golioth/elixir-hw/elixir-mechanical.kicad_sch

## KiCad design elixir-mechanical.kicad_sch (2024-07-08)

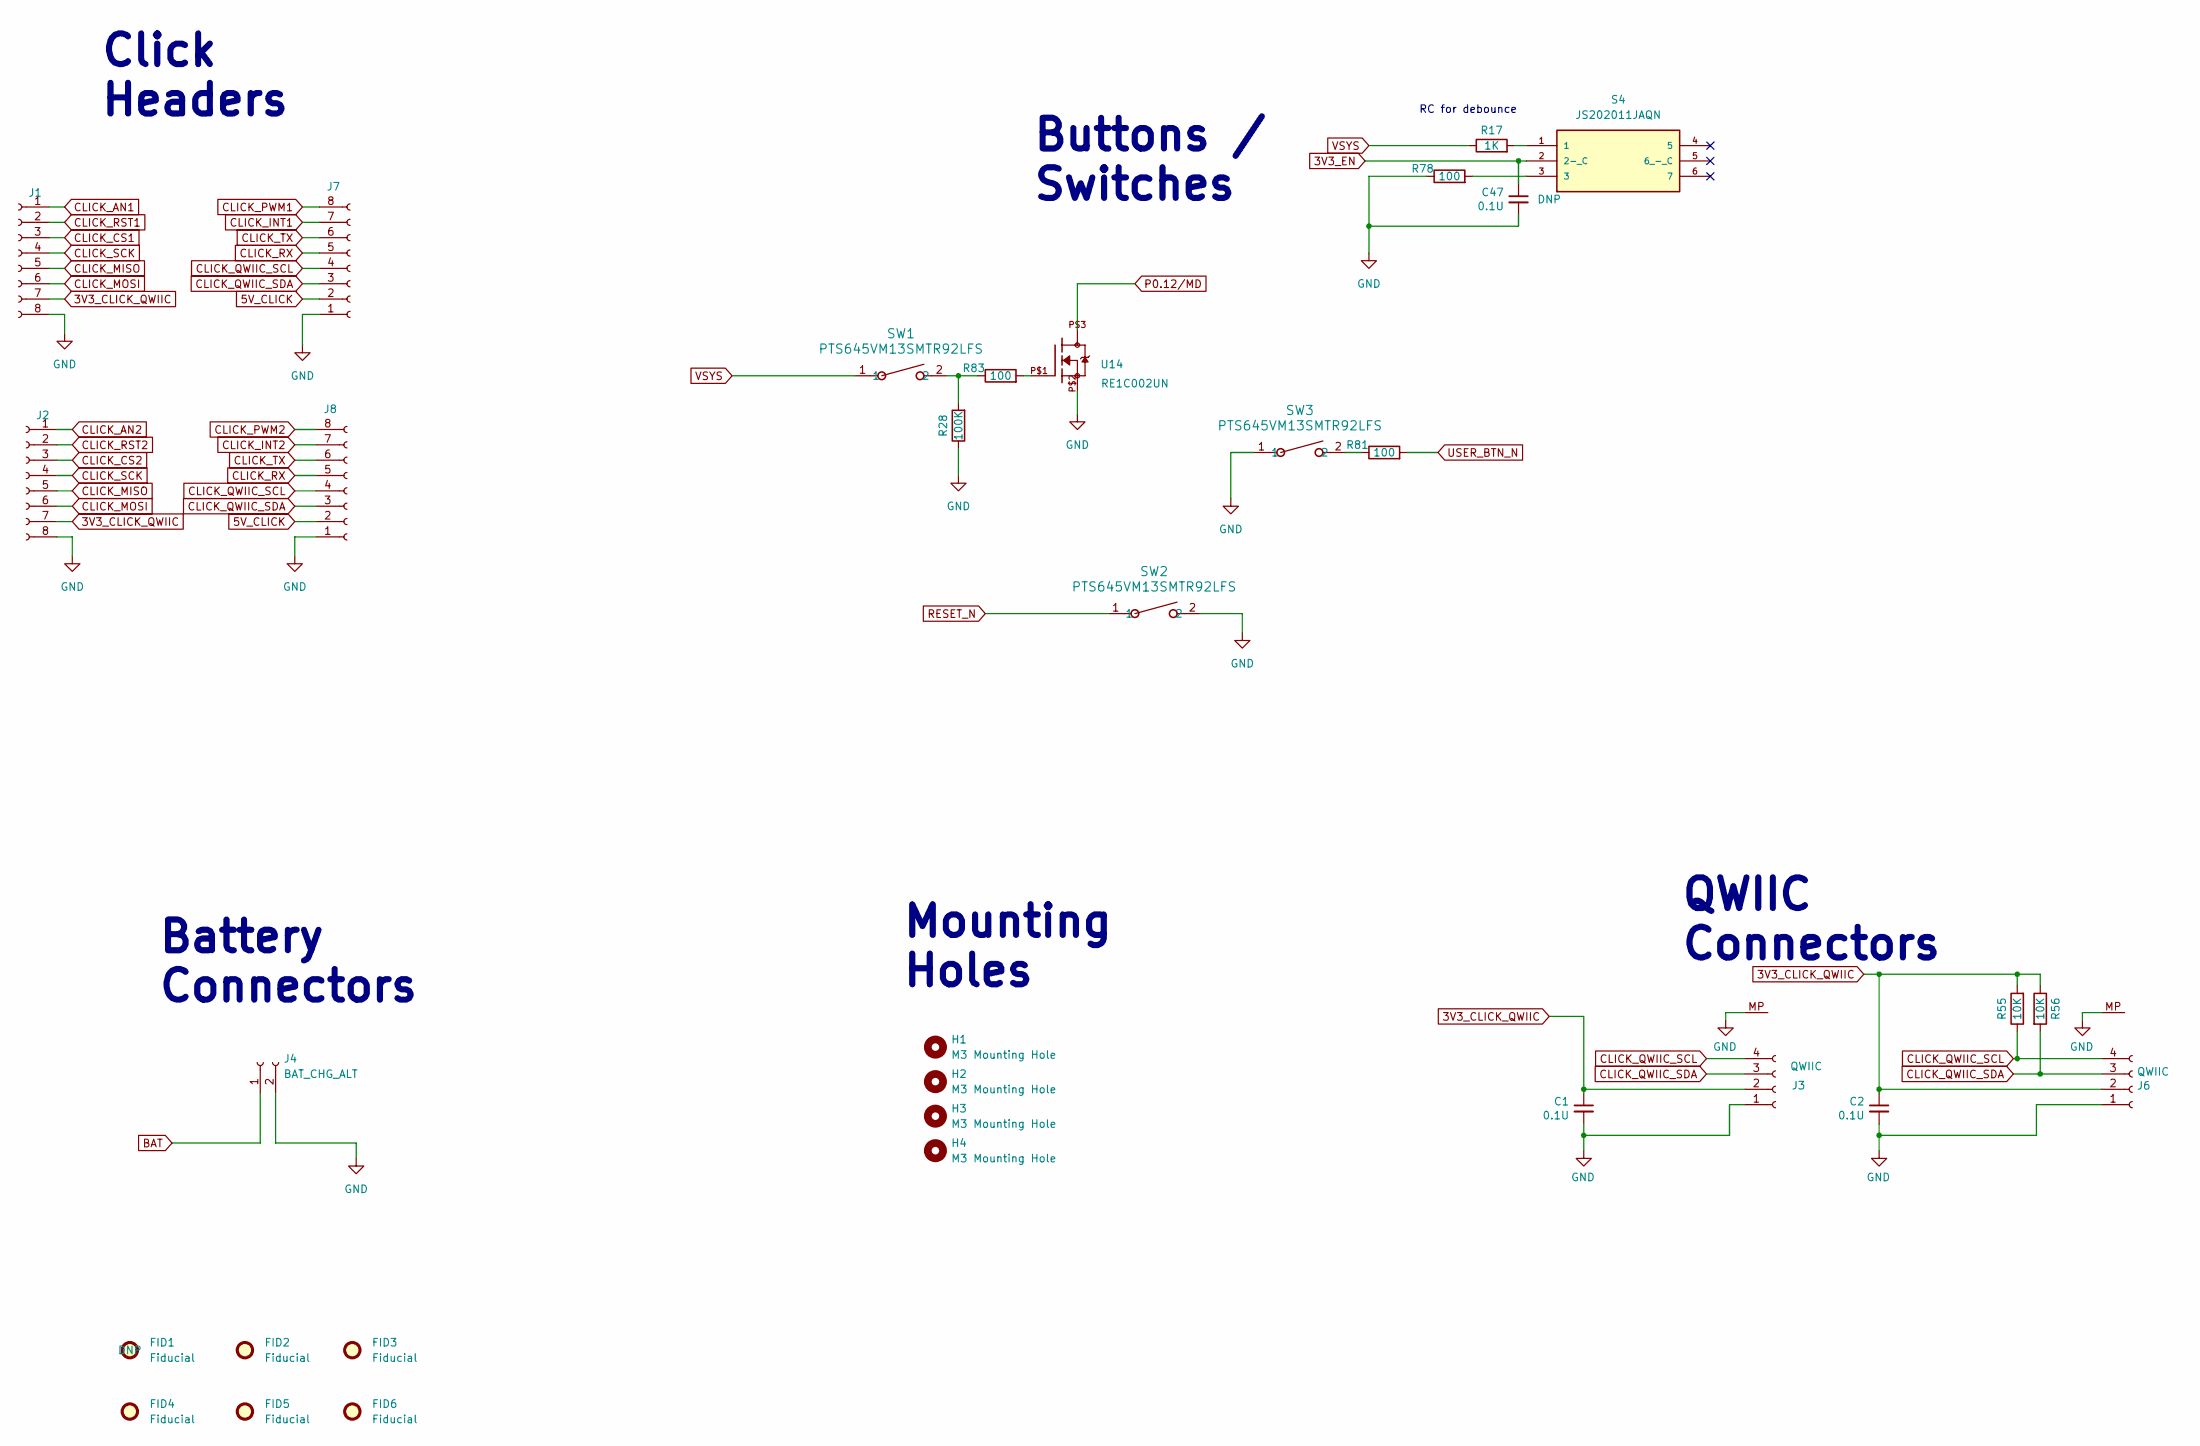
[picture p1: schematic elixir-mechanical.kicad_sch]

Parts:
C1, C2, C47: 0.1U; C_0402_1005Metric; MPN1 CL05B104KB54PNC
FID1, FID2, FID3, FID4, FID5, FID6: Fiducial; Fiducial_0.5mm_Mask1.5mm; MPN1 N/A
H1, H2, H3, H4: M3 Mounting Hole; MountingHole_3.2mm_M3; MPN1 N/A
J1, J2, J7, J8: Conn_01x08_Female; PinSocket_1x08_P2.54mm_Vertical_SMD_Pin1Right; MPN1 NPTC081KFXC-RC
J3, J6: QWIIC; JST_SH_BM04B-SRSS-TB_1x04-1MP_P1.00mm_Vertical; MPN1 BM04B-SRSS-TB(LF)(SN)
J4: BAT_CHG_ALT; JST_PH_B2B-PH-K_1x02_P2.00mm_Vertical; MPN1 B2B-PH-K-S
R17: 1K; R_0402_1005Metric; MPN1 WR04X102 JTL
R28: 100K; R_0402_1005Metric; MPN1 RT0402BRE07100KL
R55, R56: 10K; R_0402_1005Metric; MPN1 AC0402FR-0710KL
R78, R81, R83: 100; R_0402_1005Metric; MPN1 AC0402FR-07100RL
S4: JS202011JAQN; MPN1 JS202011JAQN
SW1, SW2, SW3: PTS645VM13SMTR92LFS; SW_PTS645VM13SMTR92LFS_CNK; MPN1 PTS645VN13SMTR92LFS
U14: RE1C002UN; EMT3F; MPN1 RE1C002UNTCL

Connections:
3V3_CLICK_QWIIC: C1.1, C2.1, J1.7, J2.7, J3.2, J6.2, R55.2, R56.1
3V3_EN: C47.1, S4.2 (2-_C)
5V_CLICK: J7.2, J8.2
BAT: J4.1
CLICK_AN1: J1.1
CLICK_AN2: J2.1
CLICK_CS1: J1.3
CLICK_CS2: J2.3
CLICK_INT1: J7.7
CLICK_INT2: J8.7
CLICK_MISO: J1.5, J2.5
CLICK_MOSI: J1.6, J2.6
CLICK_PWM1: J7.8
CLICK_PWM2: J8.8
CLICK_QWIIC_SCL: J3.4, J6.4, J7.4, J8.4, R55.1
CLICK_QWIIC_SDA: J3.3, J6.3, J7.3, J8.3, R56.2
CLICK_RST1: J1.2
CLICK_RST2: J2.2
CLICK_RX: J7.5, J8.5
CLICK_SCK: J1.4, J2.4
CLICK_TX: J7.6, J8.6
GND: C1.2, C2.2, C47.2, J1.8, J2.8, J3.1, J3.MP, J4.2, J6.1, J6.MP, J7.1, J8.1, R28.1, R78.1, SW2.2, SW3.1, U14.P$2
unnamed: R17.2, S4.1
unnamed: R28.2, R83.1, SW1.2
unnamed: R78.2, S4.3
unnamed: R81.1, SW3.2
unnamed: R83.2, U14.P$1
P0.12/MD: U14.P$3
RESET_N: SW2.1
USER_BTN_N: R81.2
VSYS: R17.1, SW1.1

Notes on the sheet:
Mounting Holes
QWIIC Connectors
Click Headers
Buttons / Switches
RC for debounce
Battery Connectors
