golioth/elixir-hw/elixir-nrf9160.kicad_sch

## KiCad design elixir-nrf9160.kicad_sch (2025-02-15)

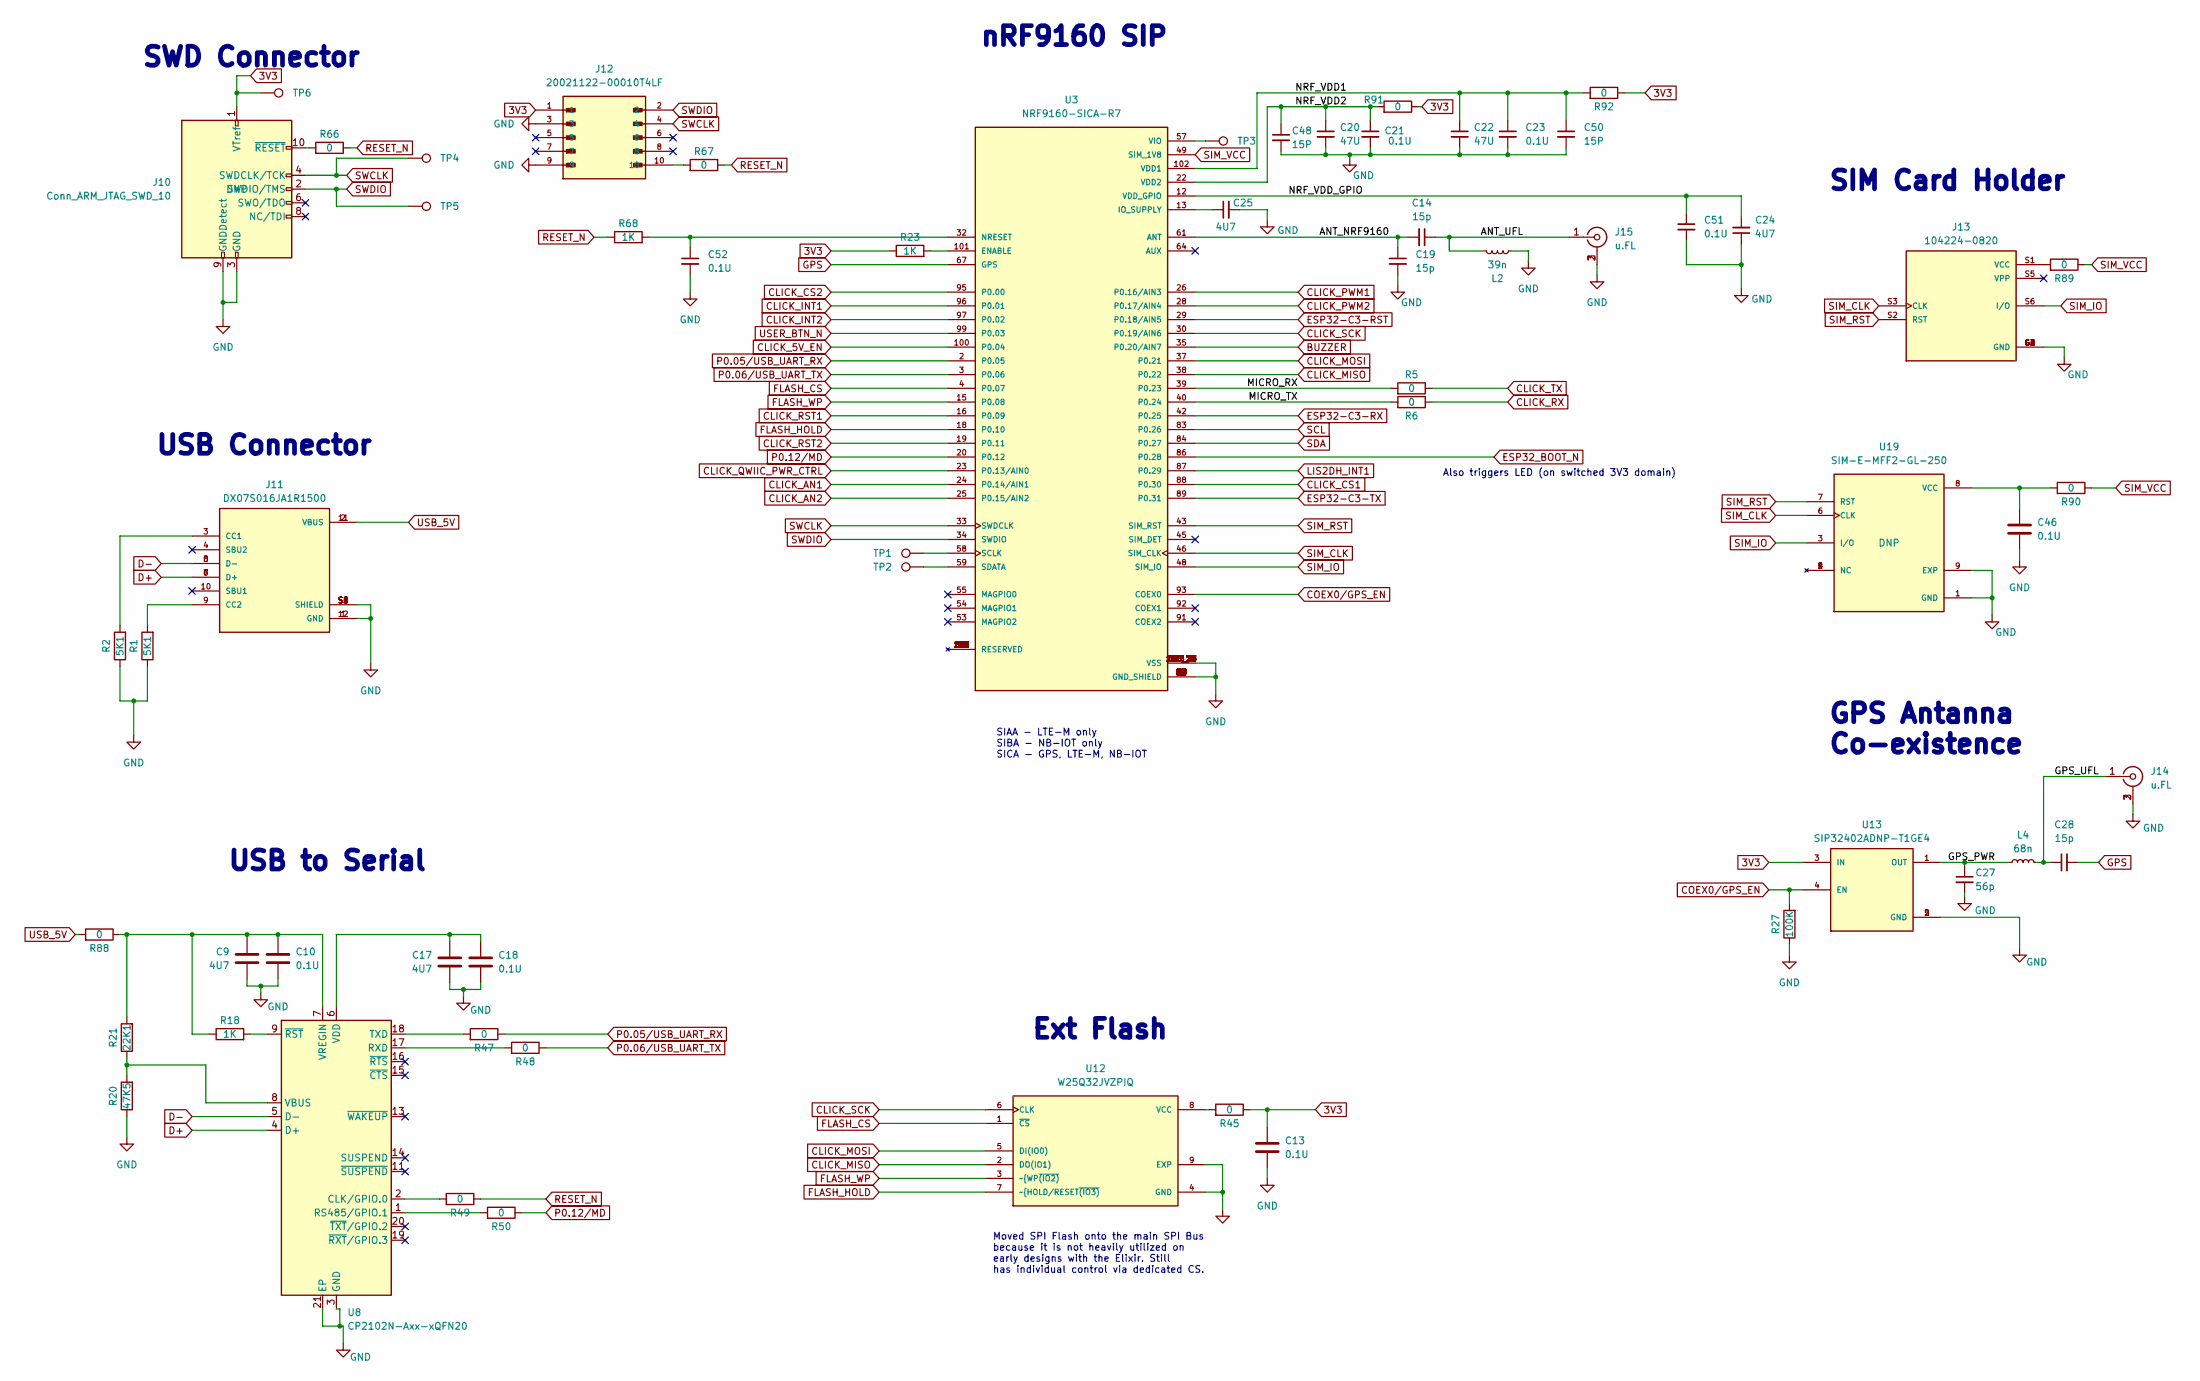
[picture p2: schematic elixir-nrf9160.kicad_sch]

Parts:
C9, C17, C24, C25: 4U7; C_0805_2012Metric; Voltage 16V; MPN1 CL21B475KOFNFNE
C10, C13, C18, C21, C23, C46, C51, C52: 0.1U; C_0402_1005Metric; MPN1 CL05B104KB54PNC
C14, C19, C28: 15p; C_0402_1005Metric; MPN1 0402N150J250CT
C20, C22: 47U; C_1210_3225Metric; Voltage 6.3V; MPN1 CL32A476MQJNNNE
C27: 56p; C_0402_1005Metric; MPN1 KGM05ACG1H560KH
C48, C50: 15P; C_0402_1005Metric; MPN1 CL05C150JB5NNND
J10: Conn_ARM_JTAG_SWD_10; TAG-CONNECT_TC2050-IDC-NL; MPN1 N/A
J11: DX07S016JA1R1500; JAE_DX07S016JA1R1500; MPN1 DX07S016JA1R1500
J12: 20021122-00010T4LF; AMPHENOL_20021122-00010T4LF; MPN1 20021122-00010T4LF
J13: 104224-0820; MOLEX_104224-0820; MPN1 1042240820
J14, J15: u.FL; TE_1909763-1; MPN1 1909763-1
L2: 39n; L_0402_1005Metric; MPN1 LRC0402CJ39NGV001T
L4: 68n; L_0402_1005Metric; MPN1 MHQ1005P68NJT000
R1, R2: 5K1; R_0402_1005Metric; MPN1 RC0402FR-135K1L
R5, R6, R45, R47, R48, R49, R50, R66, R67, R88, R89, R90, R91, R92: 0; R_0402_1005Metric; MPN1 RMCF0402ZT0R00
R18, R23, R68: 1K; R_0402_1005Metric; MPN1 WR04X102 JTL
R20: 47K5; R_0402_1005Metric; MPN1 RC0402FR-0747K5L
R21: 22K1; R_0402_1005Metric; MPN1 RC0402FR-0722K1L
R27: 100K; R_0402_1005Metric; MPN1 RT0402BRE07100KL
TP1, TP2, TP3, TP4, TP5, TP6: TestPoint; TestPoint_Pad_D1.5mm; MPN1 N/A
U3: NRF9160-SICA-R7; XCVR_NRF9160-SIBA-R; MPN1 NRF9160-SICA-R7
U8: CP2102N-Axx-xQFN20; WFQFN-20; MPN1 CP2102N-A02-GQFN20
U12: W25Q32JVZPIQ; SON127P600X500X80-9N; MPN1 W25Q32JVZPIQ
U13: SIP32402ADNP-T1GE4; SON50P120X160X60-5N; MPN1 SIP32409DNP-T1-GE4
U19: SIM-E-MFF2-GL-250; PSON127P500X600X82-9N; MPN1 GL1-MFF2-250

Connections:
3V3: C13.1, J10.1 (VTref), J12.1, R23.1, R45.1, R91.1, R92.1, TP6.1, U13.3 (IN)
ANT_NRF9160: C14.2, C19.1, U3.61 (ANT)
ANT_UFL: C14.1, J15.1 (In), L2.1
BUZZER: U3.35 (P0.20/AIN7)
CLICK_5V_EN: U3.100 (P0.04)
CLICK_AN1: U3.24 (P0.14/AIN1)
CLICK_AN2: U3.25 (P0.15/AIN2)
CLICK_CS1: U3.88 (P0.30)
CLICK_CS2: U3.95 (P0.00)
CLICK_INT1: U3.96 (P0.01)
CLICK_INT2: U3.97 (P0.02)
CLICK_MISO: U3.38 (P0.22), U12.2 (DO(IO1))
CLICK_MOSI: U3.37 (P0.21), U12.5 (DI(IO0))
CLICK_PWM1: U3.26 (P0.16/AIN3)
CLICK_PWM2: U3.28 (P0.17/AIN4)
CLICK_QWIIC_PWR_CTRL: U3.23 (P0.13/AIN0)
CLICK_RST1: U3.16 (P0.09)
CLICK_RST2: U3.19 (P0.11)
CLICK_RX: R6.1
CLICK_SCK: U3.30 (P0.19/AIN6), U12.6 (CLK)
CLICK_TX: R5.1
COEX0/GPS_EN: R27.2, U3.93 (COEX0), U13.4 (EN)
D+: J11.6 (D+), J11.7 (D+), U8.4 (D+)
D-: J11.5 (D-), J11.8 (D-), U8.5 (D-)
ESP32-C3-RST: U3.29 (P0.18/AIN5)
ESP32-C3-RX: U3.42 (P0.25)
ESP32-C3-TX: U3.89 (P0.31)
ESP32_BOOT_N: U3.86 (P0.28)
FLASH_CS: U3.4 (P0.07), U12.1 (~CS)
FLASH_HOLD: U3.18 (P0.10), U12.7 (~HOLD/RESET~{(IO3))
FLASH_WP: U3.15 (P0.08), U12.3 (~WP~{(IO2))
GND: C9.2, C10.2, C13.2, C17.2, C18.2, C19.2, C20.2, C21.2, C22.2, C23.2, C24.1, C25.2, C27.2, C46.2, C48.2, C50.2, C51.2, C52.2, J10.3 (GND), J10.5 (GND), J10.9 (GNDDetect), J11.1 (GND), J11.12 (GND), J11.S1 (SHIELD), J11.S2 (SHIELD), J11.S3 (SHIELD), J11.S4 (SHIELD), J11.S5 (SHIELD), J11.S6 (SHIELD), J12.3, J12.9, J13.G1 (GND), J13.G2 (GND), J13.G3 (GND), J13.G4 (GND), J13.S4 (GND), J14.2 (Ext), J14.3 (Ext), J15.2 (Ext), J15.3 (Ext), L2.2, R1.1, R2.1, R20.1, R27.1, U3.1 (GND_SHIELD), U3.5 (GND_SHIELD), U3.6 (GND_SHIELD), U3.7 (GND_SHIELD), U3.8 (GND_SHIELD), U3.9 (GND_SHIELD), U3.11 (GND_SHIELD), U3.14 (GND_SHIELD), U3.17 (GND_SHIELD), U3.21 (GND_SHIELD), U3.27 (GND_SHIELD), U3.31 (GND_SHIELD), U3.36 (GND_SHIELD), U3.41 (GND_SHIELD), U3.44 (GND_SHIELD), U3.47 (GND_SHIELD), U3.50 (GND_SHIELD), U3.52 (GND_SHIELD), U3.56 (GND_SHIELD), U3.60 (GND_SHIELD), U3.62 (GND_SHIELD), U3.63 (GND_SHIELD), U3.65 (GND_SHIELD), U3.66 (GND_SHIELD), U3.68 (GND_SHIELD), U3.69 (GND_SHIELD), U3.72 (GND_SHIELD), U3.74 (GND_SHIELD), U3.75 (GND_SHIELD), U3.76 (GND_SHIELD), U3.77 (GND_SHIELD), U3.78 (GND_SHIELD), U3.79 (GND_SHIELD), U3.80 (GND_SHIELD), U3.81 (GND_SHIELD), U3.82 (GND_SHIELD), U3.85 (GND_SHIELD), U3.90 (GND_SHIELD), U3.94 (GND_SHIELD), U3.98 (GND_SHIELD), U3.103_1 (VSS), U3.103_2 (VSS), U3.103_3 (VSS), U3.103_4 (VSS), U3.103_5 (VSS), U3.103_6 (VSS), U3.103_7 (VSS), U3.103_8 (VSS), U3.103_9 (VSS), U3.103_10 (VSS), U3.103_11 (VSS), U3.103_12 (VSS), U3.103_13 (VSS), U3.103_14 (VSS), U3.103_15 (VSS), U3.103_16 (VSS), U3.103_17 (VSS), U3.103_18 (VSS), U3.103_19 (VSS), U3.103_20 (VSS), U3.103_21 (VSS), U3.103_22 (VSS), U3.103_23 (VSS), U3.103_24 (VSS), U3.103_25 (VSS), U3.103_26 (VSS), U3.103_27 (VSS), U3.103_28 (VSS), U3.103_29 (VSS), U3.103_30 (VSS), U3.103_31 (VSS), U3.103_32 (VSS), U3.103_33 (VSS), U3.103_34 (VSS), U3.103_35 (VSS), U8.3 (GND), U8.12 (GND), U8.21 (EP), U12.4 (GND), U12.9 (EXP), U13.2 (GND), U13.5 (GND), U19.1 (GND), U19.9 (EXP)
GPS: C28.2, U3.67 (GPS)
GPS_PWR: C27.1, L4.2, U13.1 (OUT)
GPS_UFL: C28.1, J14.1 (In), L4.1
LIS2DH_INT1: U3.87 (P0.29)
MICRO_RX: R5.2, U3.39 (P0.23)
MICRO_TX: R6.2, U3.40 (P0.24)
NRF_VDD1: C22.1, C23.1, C50.1, R92.2, U3.102 (VDD1)
NRF_VDD2: C20.1, C21.1, C48.1, R91.2, U3.22 (VDD2)
NRF_VDD_GPIO: C24.2, C51.1, U3.12 (VDD_GPIO)
unnamed: C9.1, C10.1, R18.1, R21.2, R88.1, U8.7 (VREGIN)
unnamed: C17.1, C18.1, U8.6 (VDD)
unnamed: C25.1, U3.13 (IO_SUPPLY)
unnamed: C46.1, R90.2, U19.8 (VCC)
unnamed: C52.1, R68.2, U3.32 (NRESET)
unnamed: J10.10 (~RESET), R66.2
unnamed: J11.3 (CC1), R2.2
unnamed: J11.9 (CC2), R1.2
unnamed: J12.10, R67.2
unnamed: J13.S1 (VCC), R89.2
unnamed: R18.2, U8.9 (~RST)
unnamed: R20.2, R21.1, U8.8 (VBUS)
unnamed: R23.2, U3.101 (ENABLE)
unnamed: R45.2, U12.8 (VCC)
unnamed: R47.2, U8.18 (TXD)
unnamed: R48.2, U8.17 (RXD)
unnamed: R49.2, U8.2 (CLK/GPIO.0)
unnamed: R50.2, U8.1 (RS485/GPIO.1)
unnamed: TP1.1, U3.58 (SCLK)
unnamed: TP2.1, U3.59 (SDATA)
unnamed: TP3.1, U3.57 (VIO)
unnamed: U3.10 (RESERVED), U3.51 (RESERVED), U3.70 (RESERVED), U3.71 (RESERVED), U3.73 (RESERVED), U3.104 (RESERVED), U3.105 (RESERVED), U3.106 (RESERVED), U3.107 (RESERVED), U3.108 (RESERVED), U3.109 (RESERVED), U3.110 (RESERVED), U3.111 (RESERVED), U3.112 (RESERVED), U3.113 (RESERVED), U3.114 (RESERVED), U3.115 (RESERVED), U3.116 (RESERVED), U3.117 (RESERVED), U3.118 (RESERVED), U3.119 (RESERVED), U3.120 (RESERVED), U3.121 (RESERVED), U3.122 (RESERVED), U3.123 (RESERVED), U3.124 (RESERVED), U3.125 (RESERVED), U3.126 (RESERVED), U3.127 (RESERVED)
unnamed: U19.2 (NC), U19.4 (NC), U19.5 (NC)
P0.05/USB_UART_RX: R47.1, U3.2 (P0.05)
P0.06/USB_UART_TX: R48.1, U3.3 (P0.06)
P0.12/MD: R50.1, U3.20 (P0.12)
RESET_N: R49.1, R66.1, R67.1, R68.1
SCL: U3.83 (P0.26)
SDA: U3.84 (P0.27)
SIM_CLK: J13.S3 (CLK), U3.46 (SIM_CLK), U19.6 (CLK)
SIM_IO: J13.S6 (I/O), U3.48 (SIM_IO), U19.3 (I/O)
SIM_RST: J13.S2 (RST), U3.43 (SIM_RST), U19.7 (RST)
SIM_VCC: R89.1, R90.1, U3.49 (SIM_1V8)
SWCLK: J10.4 (SWDCLK/TCK), J12.4, TP4.1, U3.33 (SWDCLK)
SWDIO: J10.2 (SWDIO/TMS), J12.2, TP5.1, U3.34 (SWDIO)
USB_5V: J11.2 (VBUS), J11.11 (VBUS), R88.2
USER_BTN_N: U3.99 (P0.03)

Notes on the sheet:
nRF9160 SIP
USB Connector
Ext Flash
SIAA - LTE-M only SIBA - NB-IOT only SICA - GPS, LTE-M, NB-IOT
SWD Connector
Moved SPI Flash onto the main SPI Bus because it is not heavily utilized on early designs with the Elixir. Still has individual control via dedicated CS.
GPS Antanna Co-existence
Also triggers LED (on switched 3V3 domain)
SIM Card Holder
USB to Serial
