golioth/elixir-hw/elixir-sensors.kicad_sch

## KiCad design elixir-sensors.kicad_sch (2025-02-15)

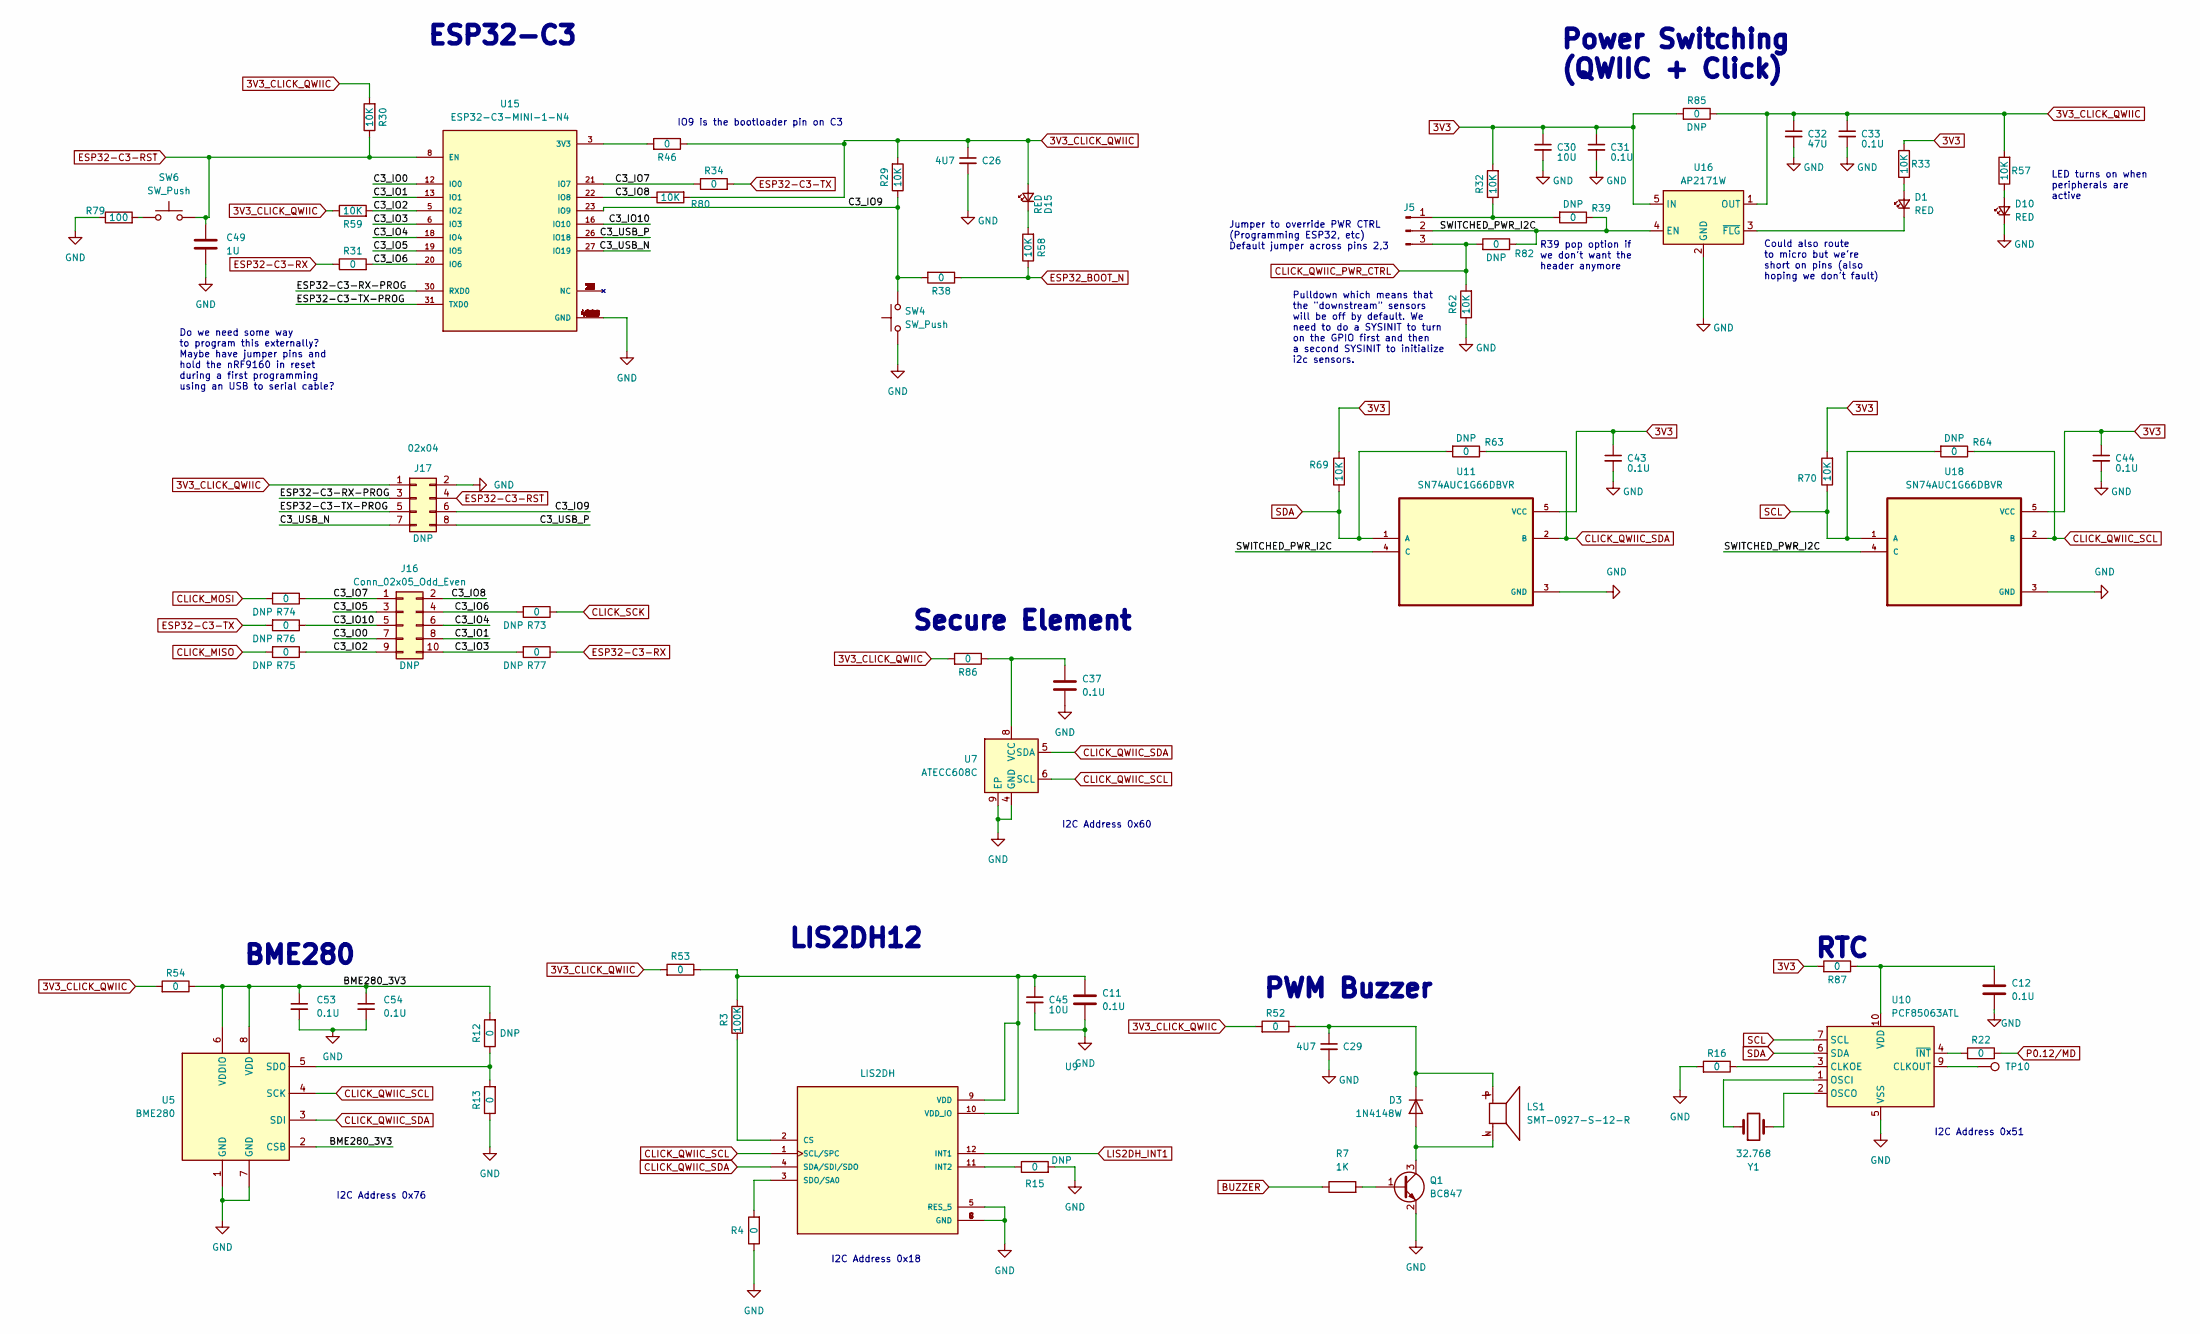
[picture p5: schematic elixir-sensors.kicad_sch]

Parts:
C11, C12, C31, C33, C37, C43, C44, C53, C54: 0.1U; C_0402_1005Metric; MPN1 CL05B104KB54PNC
C26, C29: 4U7; C_0805_2012Metric; Voltage 16V; MPN1 CL21B475KOFNFNE
C30, C45: 10U; C_1210_3225Metric; MPN1 CL32A106KAULNNE
C32: 47U; C_1210_3225Metric; Voltage 6.3V; MPN1 CL32A476MQJNNNE
C49: 1U; C_0603_1608Metric; Voltage 25V; MPN1 CL10B105KA8NNNC
D1, D10, D15: RED; LED_0402_1005Metric; MPN1 B2841URO-20C001114U1930
D3: 1N4148W; D_SOD-123; MPN1 1N4148W
J5: Conn_01x03_Pin; PinHeader_1x03_P2.54mm_Vertical_SMD_Pin1Left; MPN1 10129380-903001BLF
J16: Conn_02x05_Odd_Even; PinHeader_2x05_P2.54mm_Vertical_SMD; MPN1 10129383-910002ALF
J17: 02x04; PinHeader_2x04_P2.54mm_Vertical; MPN1 PH2-08-UA
LS1: SMT-0927-S-12-R; XDCR_SMT-0927-S-12-R; MPN1 SMT-0927-S-12-R
Q1: BC847; SOT-23; MPN1 BC847BLT3G
R3: 100K; R_0402_1005Metric; MPN1 RT0402BRE07100KL
R4, R12, R13, R15, R16, R22, R31, R34, R38, R39, R46, R52, R53, R54, R63, R64, R73, R74, R75, R76, R77, R82, R85, R86, R87: 0; R_0402_1005Metric; MPN1 RMCF0402ZT0R00
R7: 1K; R_0402_1005Metric; MPN1 WR04X102 JTL
R29, R30, R32, R33, R57, R58, R59, R62, R69, R70, R80: 10K; R_0402_1005Metric; MPN1 AC0402FR-0710KL
R79: 100; R_0402_1005Metric; MPN1 AC0402FR-07100RL
SW4, SW6: SW_Push; SW_SPST_PTS810; MPN1 PTS810 SJG 250 SMTR LFS
TP10: TestPoint; TestPoint_Pad_D1.5mm; MPN1 N/A
U5: BME280; Bosch_LGA-8_2.5x2.5mm_P0.65mm_ClockwisePinNumbering; MPN1 BME280
U7: ATECC608C; DFN-8-1EP_3x2mm_P0.5mm_EP1.3x1.5mm; MPN1 ATECC608C-MAHDA-T
U9: LIS2DH; SENSOR_LIS2DH12; MPN1 LIS2DH12TR
U10: PCF85063ATL; DFN-10-1EP_2.6x2.6mm_P0.5mm_EP1.3x2.2mm; MPN1 PCF85063ATL/1,118
U11, U18: SN74AUC1G66DBVR; SOT95P280X145-5N; MPN1 SN74AUC1G66DBVR
U15: ESP32-C3-MINI-1-N4; XCVR_ESP32-C3-MINI-1-N4; MPN1 ESP32-C3-MINI-1-N4
U16: AP2171W; SOT-23-5; MPN1 AP2171WG-7
Y1: 32.768; Crystal_SMD_3215-2Pin_3.2x1.5mm; MPN1 ABS07AIG-32.768KHZ-1-T

Connections:
3V3: C30.1, C31.1, C43.1, C44.1, R32.2, R33.2, R69.2, R70.2, R85.2, R87.2, U11.5 (VCC), U16.5 (IN), U18.5 (VCC)
3V3_CLICK_QWIIC: C26.1, C32.1, C33.1, D15.2 (A), J17.1, R29.2, R30.2, R46.1, R52.2, R53.2, R54.2, R57.2, R59.1, R80.2, R85.1, R86.2, U16.1 (OUT)
BME280_3V3: C53.1, C54.1, R12.2, R54.1, U5.2 (CSB), U5.6 (VDDIO), U5.8 (VDD)
BUZZER: R7.1
C3_IO0: J16.7, U15.12 (IO0)
C3_IO1: J16.8, U15.13 (IO1)
C3_IO2: J16.9, R59.2, R75.1, U15.5 (IO2)
C3_IO3: J16.10, R77.2, U15.6 (IO3)
C3_IO4: J16.6, U15.18 (IO4)
C3_IO5: J16.3, U15.19 (IO5)
C3_IO6: J16.4, R31.2, R73.2, U15.20 (IO6)
C3_IO7: J16.1, R34.1, R74.1, U15.21 (IO7)
C3_IO8: J16.2, R80.1, U15.22 (IO8)
C3_IO9: J17.6, R29.1, R38.2, SW4.2, U15.23 (IO9)
C3_IO10: J16.5, R76.1, U15.16 (IO10)
C3_USB_N: J17.7, U15.27 (IO19)
C3_USB_P: J17.8, U15.26 (IO18)
CLICK_MISO: R75.2
CLICK_MOSI: R74.2
CLICK_QWIIC_PWR_CTRL: J5.3, R62.2, R82.2
CLICK_QWIIC_SCL: R64.1, U5.4 (SCK), U7.6 (SCL), U9.1 (SCL/SPC), U18.2 (B)
CLICK_QWIIC_SDA: R63.1, U5.3 (SDI), U7.5 (SDA), U9.4 (SDA/SDI/SDO), U11.2 (B)
CLICK_SCK: R73.1
ESP32-C3-RST: C49.1, J17.4, R30.1, SW6.2, U15.8 (EN)
ESP32-C3-RX: R31.1, R77.1
ESP32-C3-RX-PROG: J17.3, U15.30 (RXD0)
ESP32-C3-TX: R34.2, R76.2
ESP32-C3-TX-PROG: J17.5, U15.31 (TXD0)
ESP32_BOOT_N: R38.1, R58.1
GND: C11.2, C12.2, C26.2, C29.2, C30.2, C31.2, C32.2, C33.2, C37.2, C43.2, C44.2, C45.2, C49.2, C53.2, C54.2, D10.1 (K), J17.2, Q1.2 (E), R4.1, R13.1, R15.2, R16.2, R62.1, R79.1, SW4.1, U5.1 (GND), U5.7 (GND), U7.4 (GND), U7.9 (EP), U9.5 (RES_5), U9.6 (GND), U9.7 (GND), U9.8 (GND), U10.5 (VSS), U11.3 (GND), U15.1 (GND), U15.2 (GND), U15.11 (GND), U15.14 (GND), U15.36 (GND), U15.37 (GND), U15.38 (GND), U15.39 (GND), U15.40 (GND), U15.41 (GND), U15.42 (GND), U15.43 (GND), U15.44 (GND), U15.45 (GND), U15.46 (GND), U15.47 (GND), U15.48 (GND), U15.49_1 (GND), U15.49_2 (GND), U15.49_3 (GND), U15.49_4 (GND), U15.49_5 (GND), U15.49_6 (GND), U15.49_7 (GND), U15.49_8 (GND), U15.49_9 (GND), U15.50 (GND), U15.51 (GND), U15.52 (GND), U15.53 (GND), U16.2 (GND), U18.3 (GND)
LIS2DH_INT1: U9.12 (INT1)
unnamed: C11.1, C45.1, R3.2, R53.1, U9.9 (VDD), U9.10 (VDD_IO)
unnamed: C12.1, R87.1, U10.10 (VDD)
unnamed: C29.1, D3.1 (K), LS1.P, R52.1
unnamed: C37.1, R86.1, U7.8 (VCC)
unnamed: D1.1 (K), U16.3 (~FLG)
unnamed: D1.2 (A), R33.1
unnamed: D3.2 (A), LS1.N, Q1.3 (C)
unnamed: D10.2 (A), R57.1
unnamed: D15.1 (K), R58.2
unnamed: J5.1, R32.1, R39.2
unnamed: Q1.1 (B), R7.2
unnamed: R3.1, U9.2 (CS)
unnamed: R4.2, U9.3 (SDO/SA0)
unnamed: R12.1, R13.2, U5.5 (SDO)
unnamed: R15.1, U9.11 (INT2)
unnamed: R16.1, U10.3 (CLKOE)
unnamed: R22.2, U10.4 (~INT)
unnamed: R46.2, U15.3 (3V3)
unnamed: R79.2, SW6.1
unnamed: TP10.1, U10.9 (CLKOUT)
unnamed: U10.1 (OSCI), Y1.1
unnamed: U10.2 (OSCO), Y1.2
unnamed: U15.4 (NC), U15.7 (NC), U15.9 (NC), U15.10 (NC), U15.15 (NC), U15.17 (NC), U15.24 (NC), U15.25 (NC), U15.28 (NC), U15.29 (NC), U15.32 (NC), U15.33 (NC), U15.34 (NC), U15.35 (NC)
P0.12/MD: R22.1
SCL: R64.2, R70.1, U10.7 (SCL), U18.1 (A)
SDA: R63.2, R69.1, U10.6 (SDA), U11.1 (A)
SWITCHED_PWR_I2C: J5.2, R39.1, R82.1, U11.4 (C), U16.4 (EN), U18.4 (C)

Notes on the sheet:
Pulldown which means that the "downstream" sensors will be off by default. We need to do a SYSINIT to turn on the GPIO first and then a second SYSINIT to initialize i2c sensors.
I2C Address 0x18
ESP32-C3
Do we need some way to program this externally? Maybe have jumper pins and hold the nRF9160 in reset during a first programming using an USB to serial cable?
PWM Buzzer
I2C Address 0x60
I2C Address 0x51
BME280
R39 pop option if we don't want the header anymore
RTC
Secure Element
LED turns on when peripherals are active
Jumper to override PWR CTRL (Programming ESP32, etc) Default jumper across pins 2,3
I2C Address 0x76
IO9 is the bootloader pin on C3
Could also route to micro but we're short on pins (also hoping we don't fault)
Power Switching (QWIIC + Click)
LIS2DH12
